GadgetReboot/Piezo_Interface/WiringDiagram.jpg

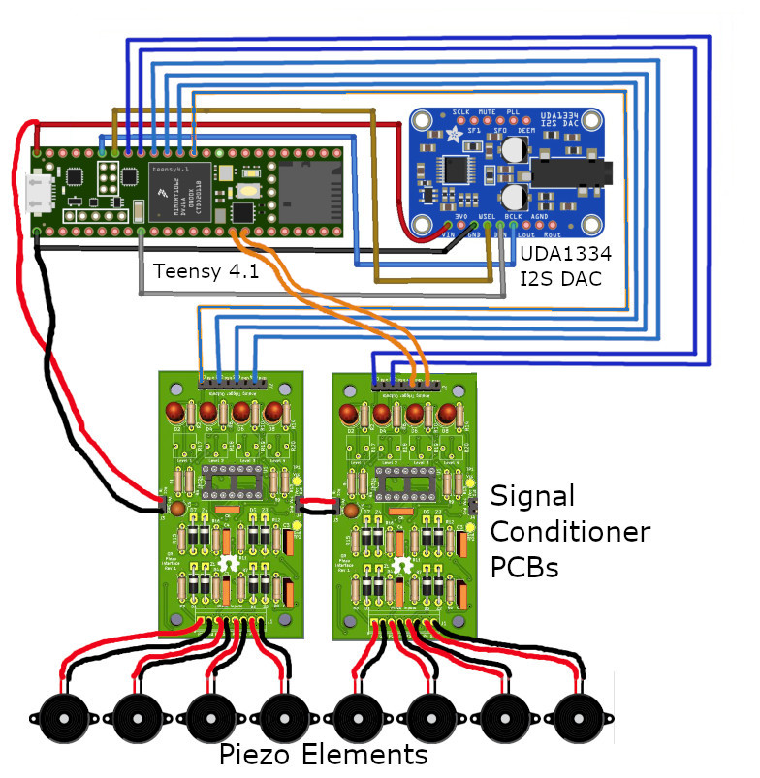
WiringDiagram.jpg
