GadgetReboot/Piezo_Interface/README.md

# Piezo_Interface
4 Channel Piezo element signal conditioner for triggering analog/digital inputs
