GadgetReboot/Piezo_Interface/sketch/readme.md

Teensy 4.1 Drum Kit
8 analog inputs, level sensitive, triggered by piezo elements
I2S digital audio out
