GadgetReboot/Piezo_Interface/Piezo_Interface_Schematic.pdf

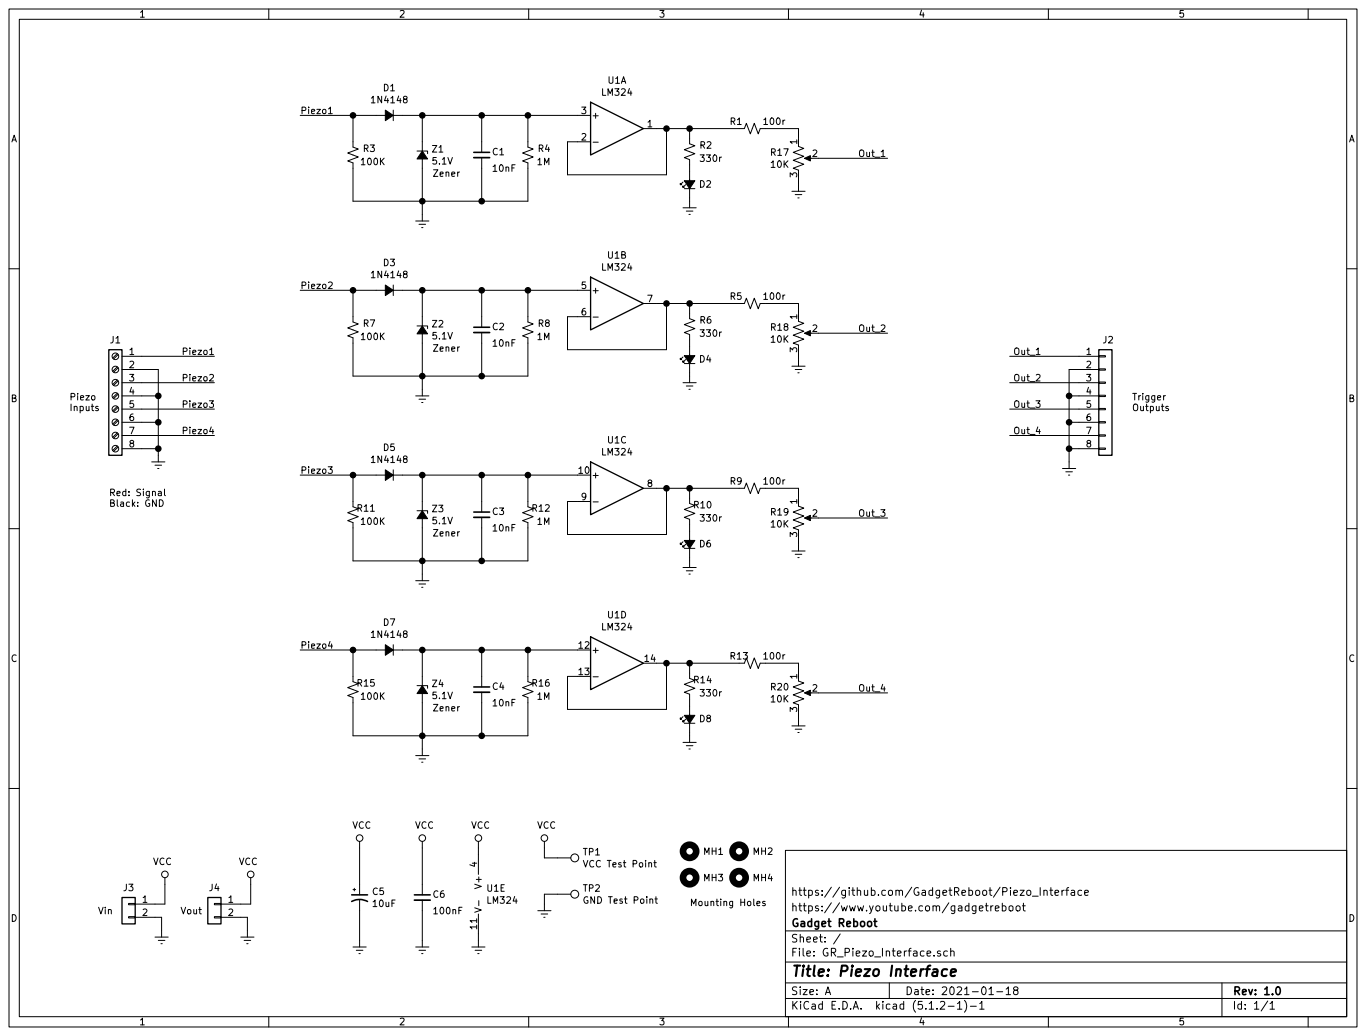
[picture p2: page 1]

https://github.com/GadgetReboot/Piezo_Interface VCC

TP1 VCC Test Point TP2 GND Test Point VCC

https://www.youtube.com/gadgetreboot
File: GR_Piezo_Interface.sch Sheet: / Gadget Reboot

Id: 1/1 Title: Piezo Interface
