GadgetReboot/Piezo_Interface/KiCad/GR_Piezo_Interface.kicad_pcb

## KiCad design KiCad/GR_Piezo_Interface.kicad_pcb (2021-01-29)

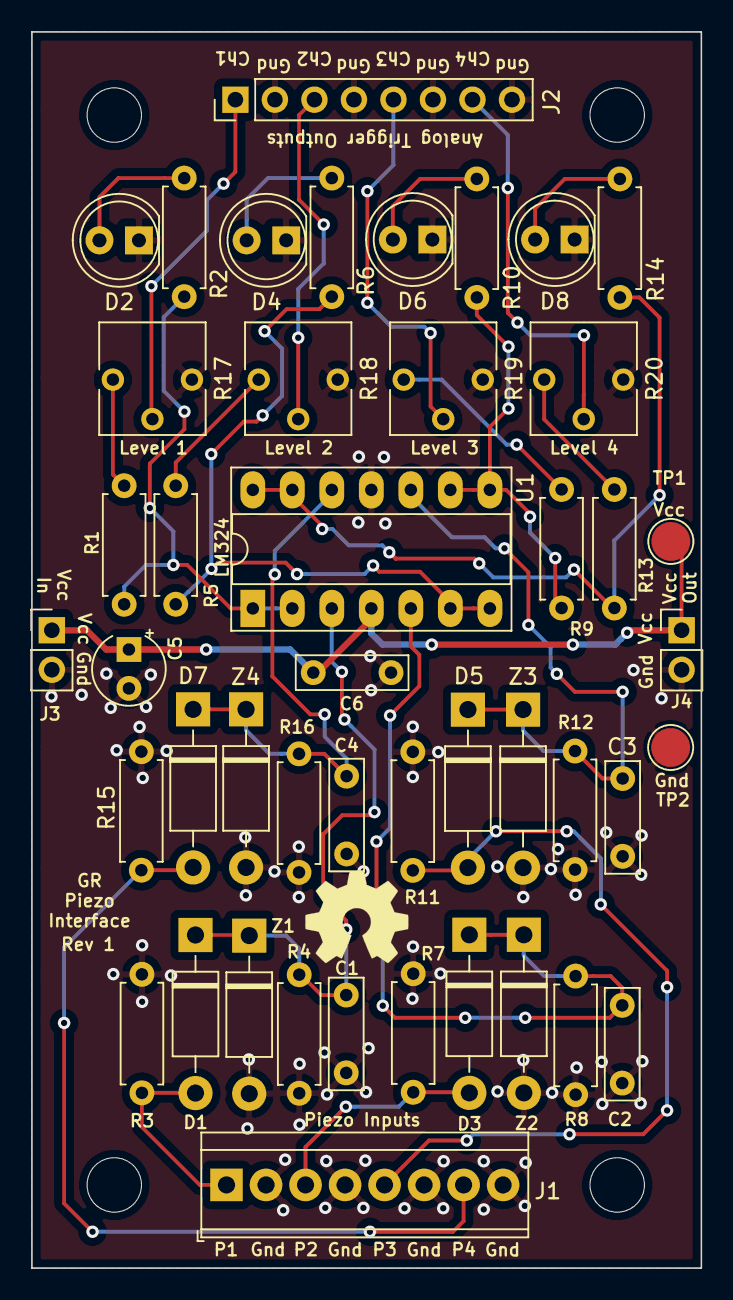
[picture p3: board GR_Piezo_Interface.kicad_pcb from above]

Board: 2 copper layers, 43.0 x 79.5 mm, 49 parts (0 on the bottom side), 26 nets.

Parts:
C1, C2, C3, C4: 10nF; C_Rect_L7.0mm_W2.0mm_P5.00mm
C5: 10uF; CP_Radial_Tantal_D4.5mm_P2.50mm
C6: 100nF; C_Rect_L7.0mm_W2.0mm_P5.00mm
D1, D3, D5, D7: 1N4148; D_DO-41_SOD81_P10.16mm_Horizontal
D2, D4, D6, D8: LED_Small_ALT; LED_D5.0mm
J1: Screw_Terminal_01x08; TerminalBlock_TE_282834-8_1x08_P2.54mm_Horizontal
J2: Conn_01x08; PinHeader_1x08_P2.54mm_Vertical
J3: Vin; PinHeader_1x02_P2.54mm_Vertical
J4: Vout; PinHeader_1x02_P2.54mm_Vertical
MH1, MH2, MH3, MH4: MountingHole; MountingHole_3.5mm
R1, R5, R9, R13: 100r; R_Axial_DIN0207_L6.3mm_D2.5mm_P7.62mm_Horizontal
R2, R6, R10, R14: 330r; R_Axial_DIN0207_L6.3mm_D2.5mm_P7.62mm_Horizontal
R3, R7, R11, R15: 100K; R_Axial_DIN0207_L6.3mm_D2.5mm_P7.62mm_Horizontal
R4, R8, R12, R16: 1M; R_Axial_DIN0207_L6.3mm_D2.5mm_P7.62mm_Horizontal
R17, R18, R19, R20: 10K; Potentiometer_Vishay_T73YP_Vertical
TP1: VCC Test Point; TestPoint_Pad_D2.5mm
TP2: GND Test Point; TestPoint_Pad_D2.5mm
U1: LM324; DIP-14_W7.62mm_Socket_LongPads
Z1, Z2, Z3, Z4: 5.1V; D_DO-41_SOD81_P10.16mm_Horizontal

Connections:
/Out_1: J2.1, R17.2
/Out_2: J2.3, R18.2
/Out_3: J2.5, R19.2
/Out_4: J2.7, R20.2
/Piezo1: D1.2, J1.1, R3.1
/Piezo2: D3.2, J1.3, R7.1
/Piezo3: D5.2, J1.5, R11.1
/Piezo4: D7.2, J1.7, R15.1
GNDREF: C1.2, C2.2, C3.2, C4.2, C5.2, C6.2, D2.1, D4.1, D6.1, D8.1, J1.2, J1.4, J1.6, J1.8, J2.2, J2.4, J2.6, J2.8, J3.2, J4.2, R3.2, R4.2, R7.2, R8.2, R11.2, R12.2, R15.2, R16.2, R17.3, R18.3, R19.3, R20.3, TP2.1, U1.11, Z1.2, Z2.2, Z3.2, Z4.2
unnamed: C1.1, D1.1, R4.1, U1.3, Z1.1
unnamed: C2.1, D3.1, R8.1, U1.5, Z2.1
unnamed: C3.1, D5.1, R12.1, U1.10, Z3.1
unnamed: C4.1, D7.1, R16.1, U1.12, Z4.1
unnamed: D2.2, R2.2
unnamed: D4.2, R6.2
unnamed: D6.2, R10.2
unnamed: D8.2, R14.2
unnamed: R1.1, R2.1, U1.1, U1.2
unnamed: R1.2, R17.1
unnamed: R5.1, R6.1, U1.6, U1.7
unnamed: R9.1, R10.1, U1.8, U1.9
unnamed: R13.1, R14.1, U1.13, U1.14
unnamed: R13.2, R20.1
unnamed: R5.2, R18.1
unnamed: R9.2, R19.1
VCC: C5.1, C6.1, J3.1, J4.1, TP1.1, U1.4
